IowaScaledEngineering/ckt-katoswitch/pg/ckt-katoswitch-v1.0-a710d68/ckt-katoswitch.pdf

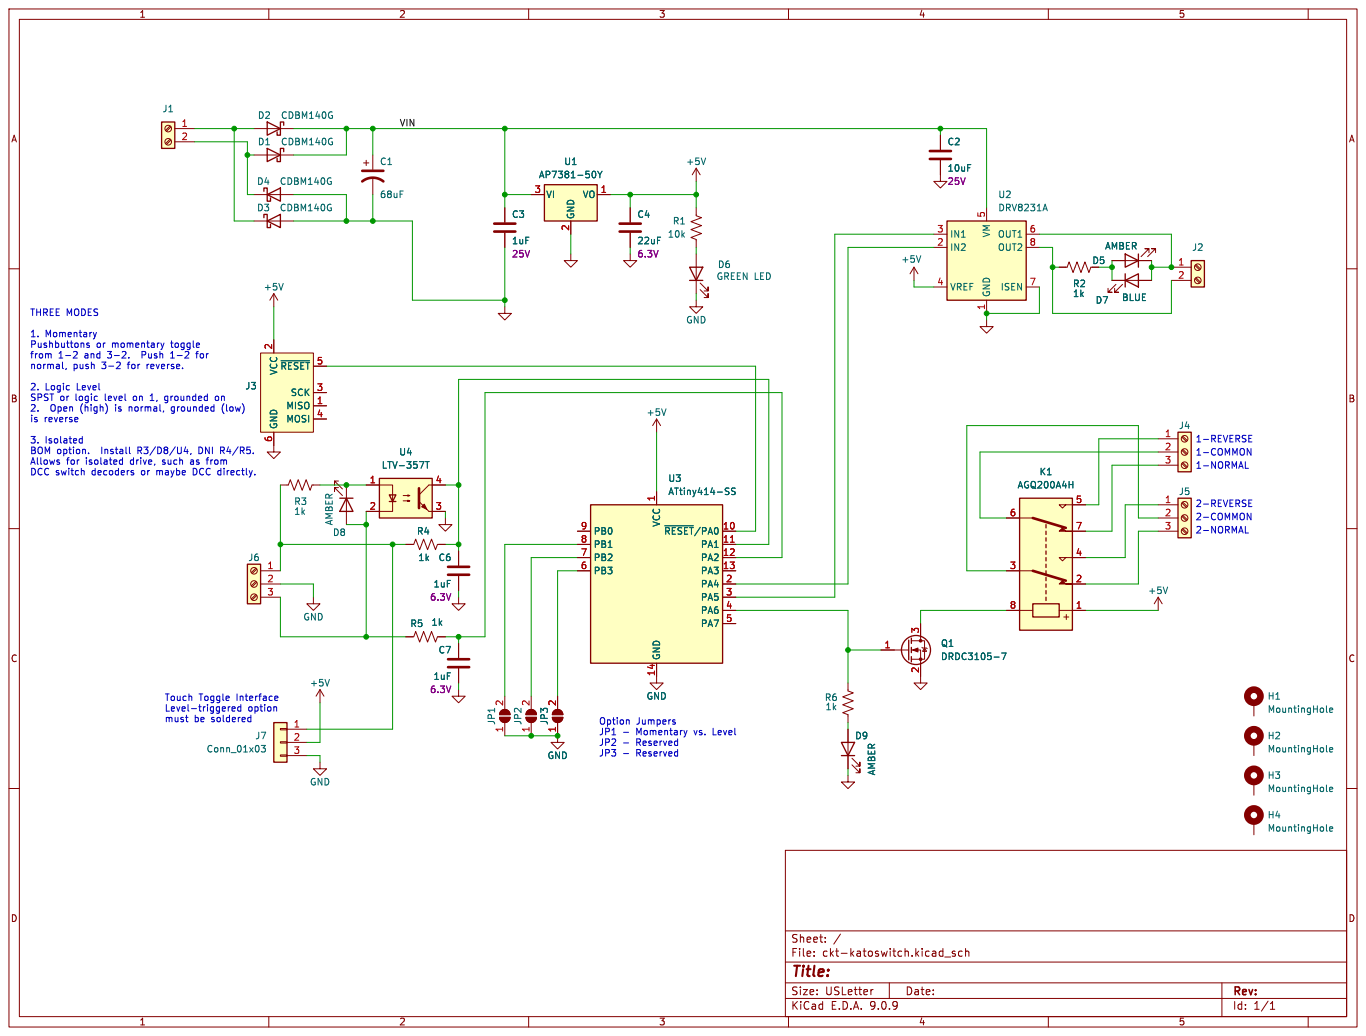
[picture p1: page 1]

6 ~{RESET}5 SCK 3 MISO 1 MOSI 4

6 ~{RESET}5 SCK 3 MISO 1 MOSI 4 U4

2. Open (high) is normal, grounded (low)
is reverse

Id: 1/1 Title: File: ckt-katoswitch.kicad_sch Sheet: /
