IowaScaledEngineering/ckt-katoswitch/kicad/ckt-katoswitch/ckt-katoswitch.kicad_pcb

## KiCad design kicad/ckt-katoswitch/ckt-katoswitch.kicad_pcb (2026-08-23)

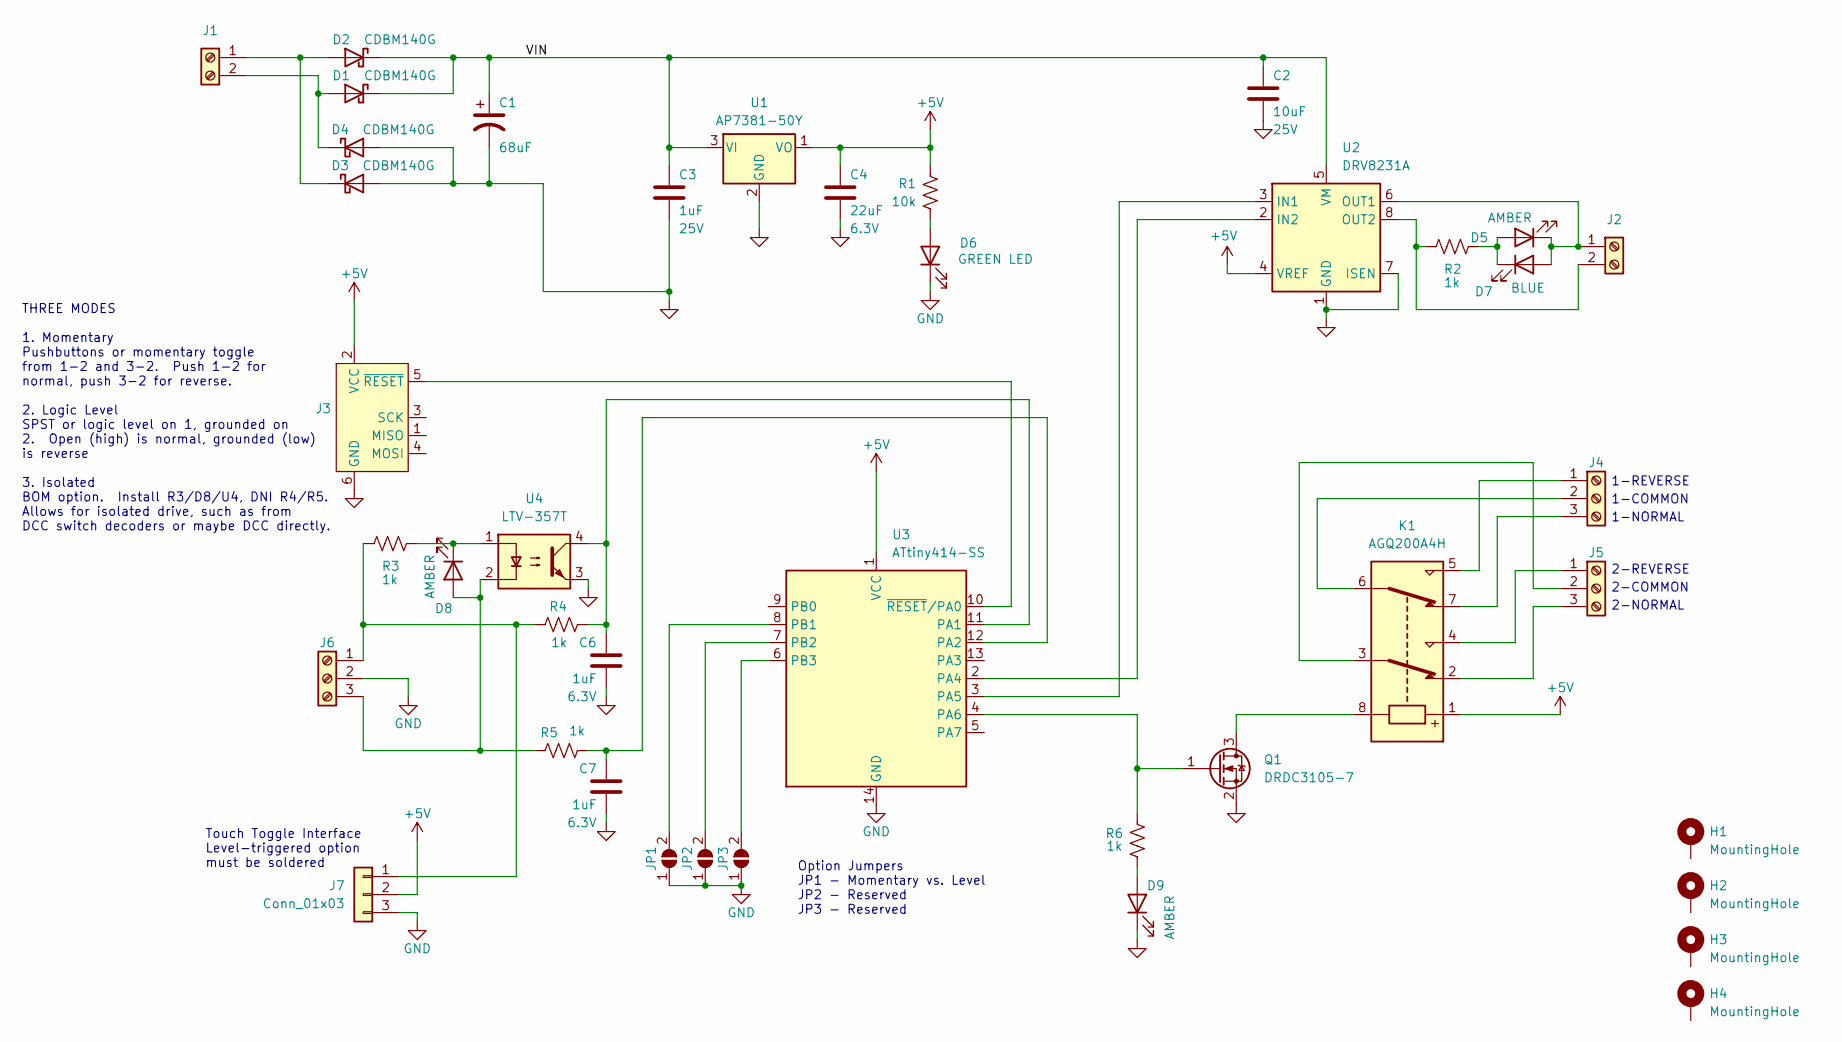
[picture p2: schematic ckt-katoswitch.kicad_sch]

Parts:
C1: 68uF; CP_Elec_6.3x5.8
C2: 10uF; C_0805_2012Metric; Voltage 25V
C3: 1uF; C_0805_2012Metric; Voltage 25V
C4: 22uF; C_0805_2012Metric; Voltage 6.3V
C6, C7: 1uF; C_0805_2012Metric; Voltage 6.3V
D1, D2, D3, D4: CDBM140G; SOD-123T
D5, D8, D9: AMBER; LED_0805_2012Metric
D6: GREEN LED; LED_0805_2012Metric
D7: BLUE; LED_0805_2012Metric
H1, H2, H3, H4: MountingHole; MountingHole_3.2mm_M3_Pad
J1, J2: Screw_Terminal_01x02; TerminalBlock_RND_205-00012_1x02_P5.00mm_Horizontal
J3: Conn_AVR_TagConnect_TC2030; Tag-Connect_TC2030-IDC-NL_2x03_P1.27mm_Vertical
J4, J5, J6: Screw_Terminal_01x02; TerminalBlock_MetzConnect_Type059_RT06303HBWC_1x03_P3.50mm_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
J7: Conn_01x03; PinHeader_1x03_P2.54mm_Vertical
JP1, JP2, JP3: SolderJumper_2_Open; SolderJumper-2_P1.3mm_Open_RoundedPad1.0x1.5mm
K1: AGQ200A4H; RELAY_AGQ_A_PAN
Q1: DRDC3105-7; SOT-23
R1: 10k; R_0805_2012Metric
R2, R3, R4, R5, R6: 1k; R_0805_2012Metric
U1: AP7381-50Y; SOT-89-3
U2: DRV8231A; Texas_HTSOP-8-1EP_3.9x4.9mm_P1.27mm_EP2.95x4.9mm_Mask2.4x3.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
U3: ATtiny414-SS; SOIC-14_3.9x8.7mm_P1.27mm
U4: LTV-357T; SO-4_4.4x3.6mm_P2.54mm

Connections:
+5V: C4.1, J3.2 (VCC), J7.2, K1.1, R1.2, U1.1 (VO), U2.4 (VREF), U3.1 (VCC)
/VIN: C1.1, C2.1, C3.1, D1.1 (K), D2.1 (K), U1.3 (VI), U2.5 (VM)
GND: C1.2, C2.2, C3.2, C4.2, C6.2, C7.2, D3.2 (A), D4.2 (A), D6.1 (K), D9.1 (K), J3.6 (GND), J6.2, J7.3, JP1.1 (A), JP2.1 (A), JP3.1 (A), Q1.2 (S), U1.2 (GND), U2.1 (GND), U2.7 (ISEN), U2.9 (GND), U3.14 (GND), U4.3
unnamed: D1.2 (A), D4.1 (K), J1.2
unnamed: D2.2 (A), D3.1 (K), J1.1
unnamed: D5.2 (A), D7.1 (K), R2.1
unnamed: D5.1 (K), D7.2 (A), J2.1, U2.6 (OUT1)
unnamed: D6.2 (A), R1.1
unnamed: D8.2 (A), J6.3, R5.2, U4.2
unnamed: D8.1 (K), R3.1, U4.1
unnamed: D9.2 (A), R6.2
unnamed: J2.2, R2.2, U2.8 (OUT2)
unnamed: J3.5 (~RESET), U3.10 (~RESET/PA0)
unnamed: J4.1, K1.5
unnamed: J4.2, K1.6
unnamed: J4.3, K1.7
unnamed: J5.1, K1.4
unnamed: J5.2, K1.3
unnamed: J5.3, K1.2
unnamed: J6.1, J7.1, R3.2, R4.2
unnamed: JP1.2 (B), U3.8 (PB1)
unnamed: JP2.2 (B), U3.7 (PB2)
unnamed: JP3.2 (B), U3.6 (PB3)
unnamed: K1.8, Q1.3 (D)
unnamed: Q1.1 (G), R6.1, U3.4 (PA6)
unnamed: U2.3 (IN1), U3.3 (PA5)
unnamed: U2.2 (IN2), U3.2 (PA4)
unnamed: C6.1, R4.1, U3.11 (PA1), U4.4
unnamed: C7.1, R5.1, U3.12 (PA2)

Notes on the sheet:
1-NORMAL
2-COMMON
2-NORMAL
1-COMMON
THREE MODES 1. Momentary Pushbuttons or momentary toggle from 1-2 and 3-2. Push 1-2 for normal, push 3-2 for reverse. 2. Logic Level SPST or logic level on 1, grounded on 2. Open (high) is normal, grounded (low) is reverse 3. Isolated BOM option. Install R3/D8/U4, DNI R4/R5. Allows for isolated dri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
Option Jumpers JP1 - Momentary vs. Level JP2 - Reserved JP3 - Reserved
1-REVERSE
2-REVERSE
Touch Toggle Interface Level-triggered option must be soldered

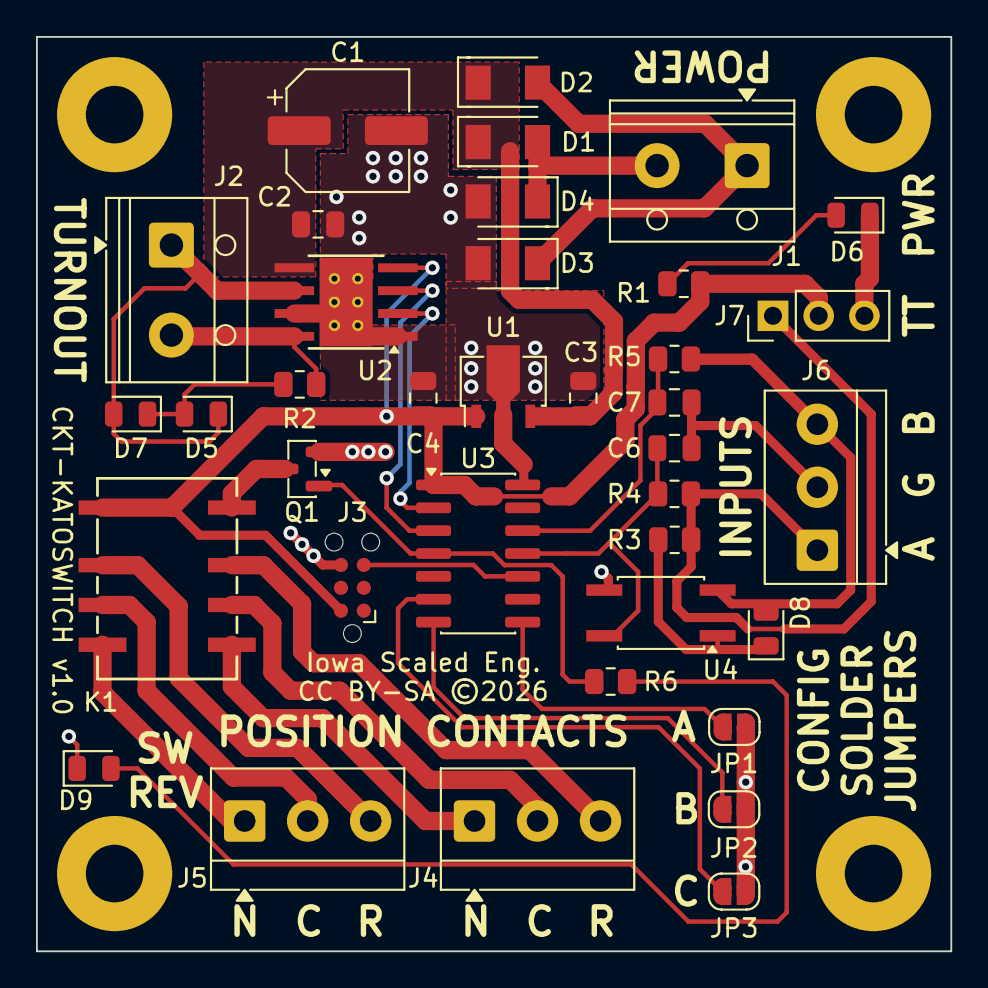
[picture p3: board ckt-katoswitch.kicad_pcb from above]

Board: 2 copper layers, 50.8 x 50.8 mm, 41 parts (0 on the bottom side), 29 nets.
