IowaScaledEngineering/ckt-katoswitch/(commit log)

2026-08-18 Initial cut at a schematic
    [ckt-katoswitch.kicad_pcb, ckt-katoswitch.kicad_sch]
2026-08-19 Add touch-toggle header since that's apparently common on T-Trak
    [ckt-katoswitch.kicad_sch]
2026-08-20 Initial cut at PCB
    [ckt-katoswitch.kicad_pcb, ckt-katoswitch.kicad_sch]
2026-08-20 Updates to add "switch reverse" indicator
    [ckt-katoswitch.kicad_pcb, ckt-katoswitch.kicad_sch]
2026-08-23 Clean up a couple small DRCs
    [ckt-katoswitch.kicad_pcb]
2026-08-31 PG v1.0
    [ckt-katoswitch-NPTH.drl, ckt-katoswitch.drl, ckt-katoswitch.gbl, ckt-katoswitch.gbo, ckt-katoswitch.gbp, ckt-katoswitch.gbr, ckt-katoswitch.gbs, ckt-katoswitch.gm1]
2026-09-29 Add watchdog, fix some bugs with level-driven switching
    [ckt-katoswitch.c]
