IowaScaledEngineering/ckt-katoswitch/(notices)

Notices in the files:
kicad/ckt-katoswitch/ckt-katoswitch.kicad_pcb:
CC BY-SA ©2026
